adafruit/Adafruit-PWM-Servo-FeatherWing-PCB/PWMServo Featherwing rev B.brd

## EAGLE design PWMServo Featherwing rev B.brd (2016-03-01)

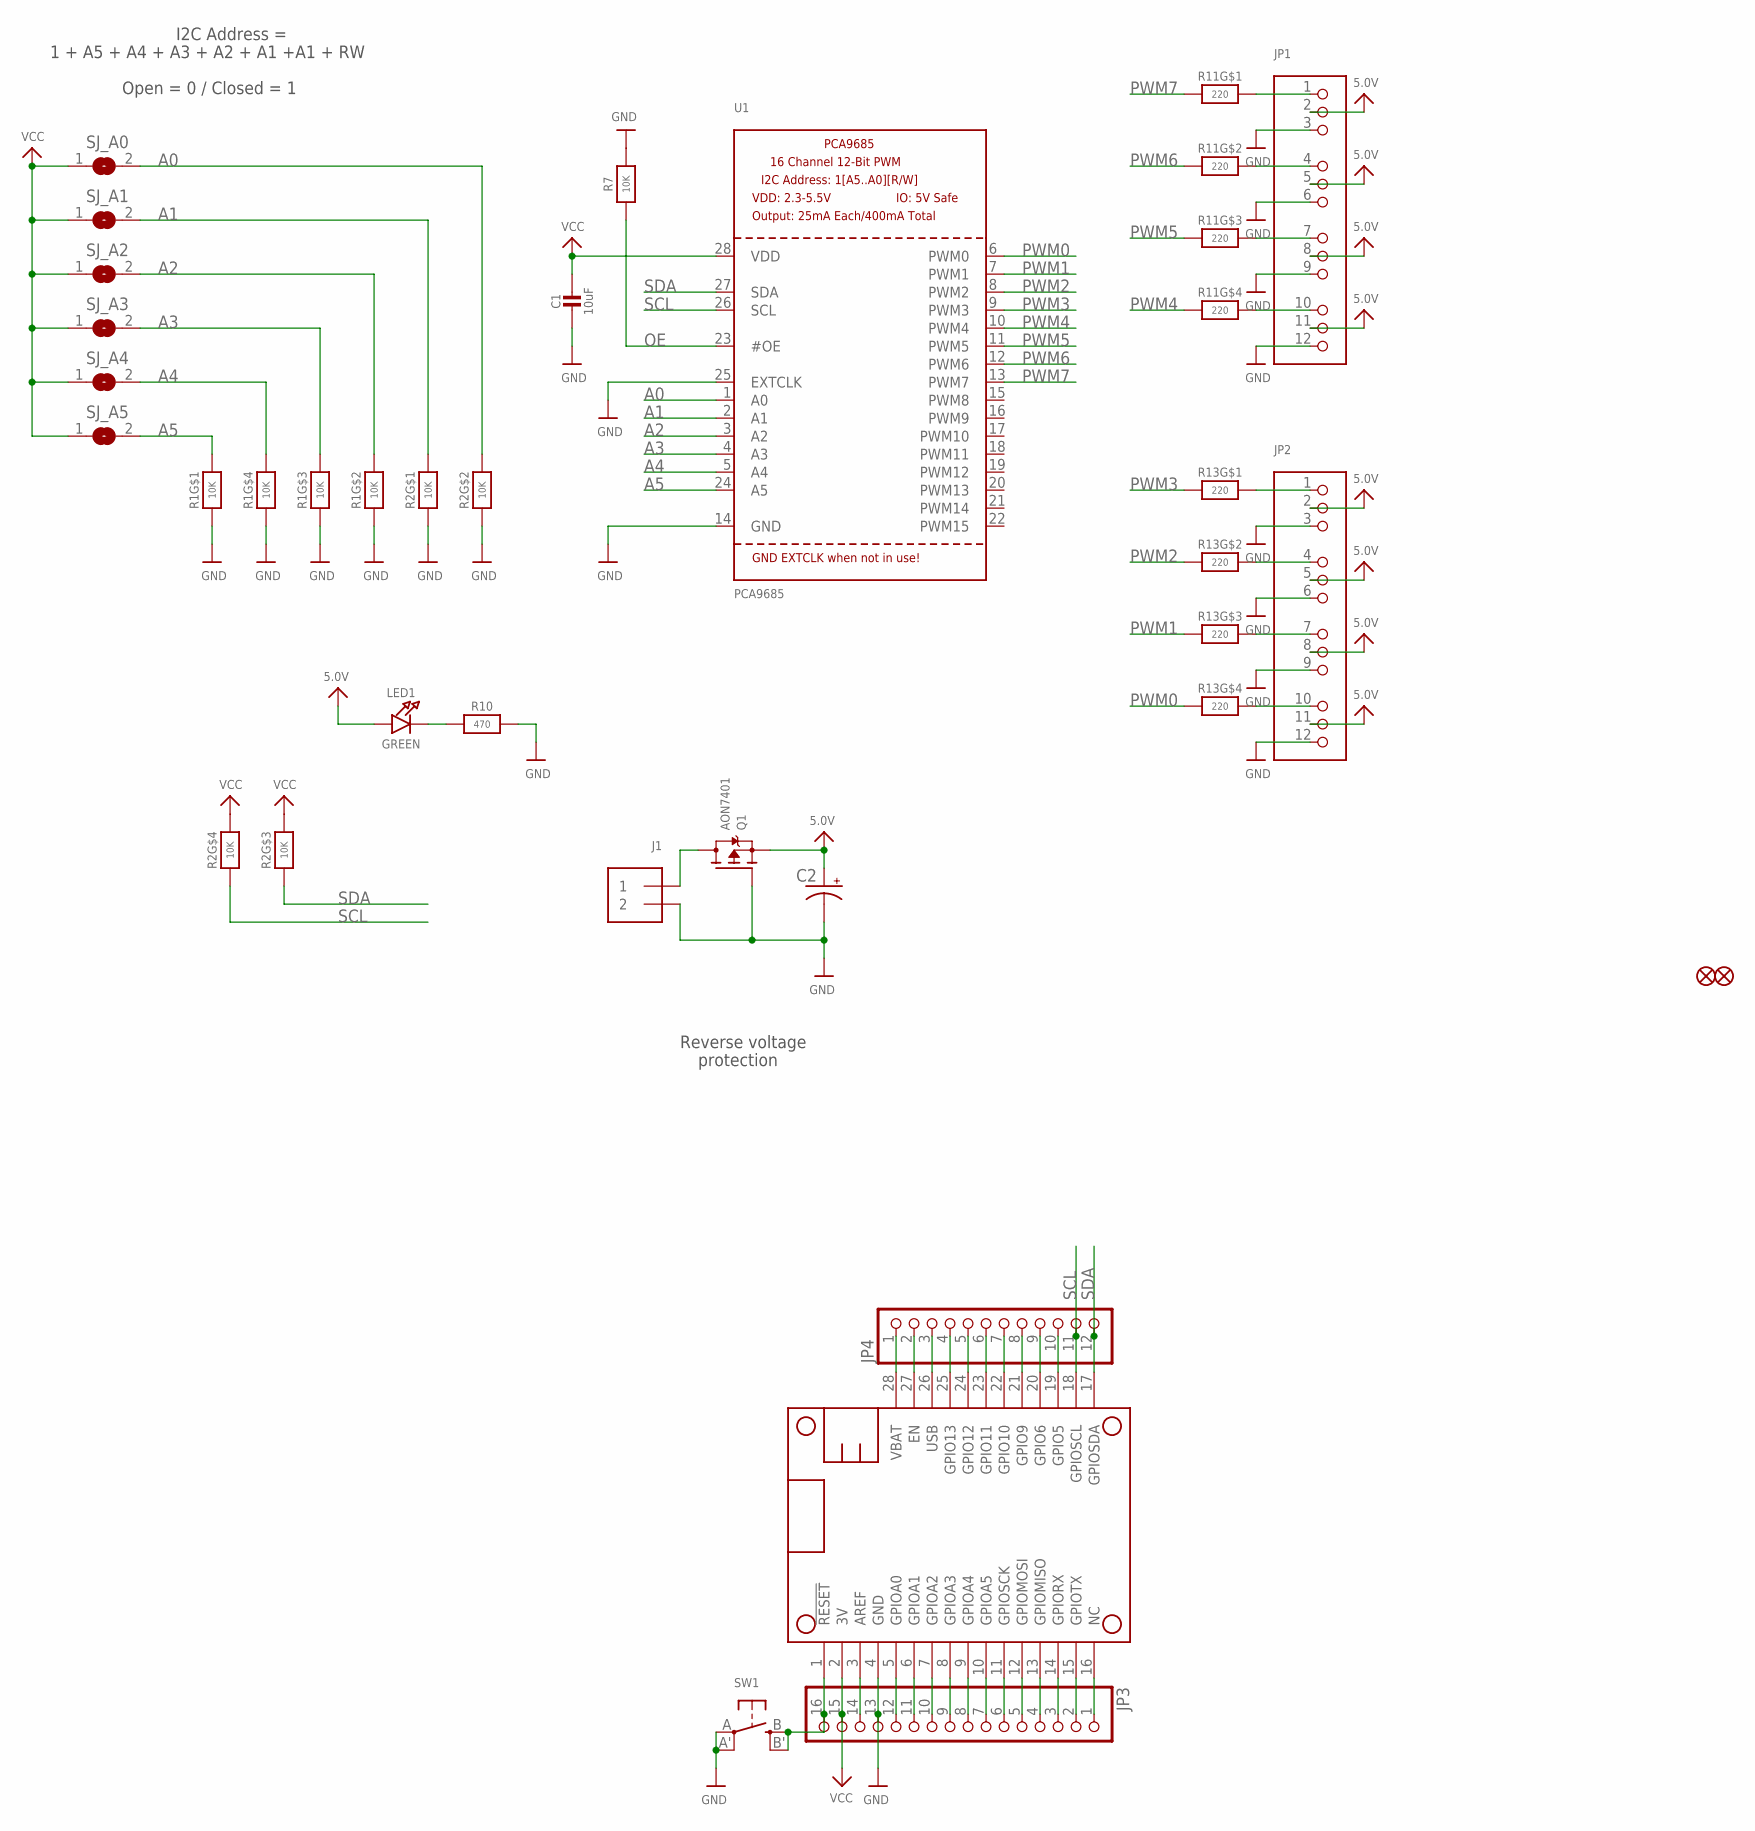
[picture p2: schematic PWMServo Featherwing rev B.sch]

Parts:
C1: 10uF; 0805-NO
C2: CPOL-USE3.5-8; E3,5-8
FID1, FID2: FIDUCIAL""; FIDUCIAL_1MM
J1: TERMBLOCK_1X2; TERMBLOCK_1X2-3.5MM
JP1, JP2: HEADER-3X04; 3X04
JP3: HEADER-1X16ROUND; 1X16_ROUND
JP4: HEADER-1X12; 1X12_ROUND
LED1: GREEN; CHIPLED_0805_NOOUTLINE
MS1: FEATHERWING
Q1: AON7401; POWERDI3333
R1, R2: 10K; RESPACK_4X0603
R7: 10K; 0805-NO
R10: 470; 0805-NO
R11, R13: 220; RESPACK_4X0603
SJ_A0, SJ_A1, SJ_A2, SJ_A3, SJ_A4, SJ_A5: SOLDERJUMPERREFLOW_NOPASTE; SOLDERJUMPER_REFLOW_NOPASTE
SW1: SWITCH_TACT_SMT4.6X2.8; BTN_KMR2_4.6X2.8
U1: PCA9685; TSSOP28

Connections:
5.0V: C2.+, JP1.2, JP1.5, JP1.8, JP1.11, JP2.2, JP2.5, JP2.8, JP2.11, LED1.A, Q1.1 (S), Q1.2 (S), Q1.3 (S)
A0: R2.7 (2), SJ_A0.2, U1.1 (A0)
A1: R2.8 (2), SJ_A1.2, U1.2 (A1)
A2: R1.7 (2), SJ_A2.2, U1.3 (A2)
A3: R1.6 (2), SJ_A3.2, U1.4 (A3)
A4: R1.5 (2), SJ_A4.2, U1.5 (A4)
A5: R1.8 (2), SJ_A5.2, U1.24 (A5)
GND: C1.2, C2.-, J1.2, JP1.3, JP1.6, JP1.9, JP1.12, JP2.3, JP2.6, JP2.9, JP2.12, JP3.13, MS1.4 (GND), Q1.4 (G), R1.1, R1.2 (1), R1.3 (1), R1.4 (1), R2.1, R2.2 (1), R7.2, R10.2, SW1.A, SW1.A' (P1), U1.14 (GND), U1.25 (EXTCLK)
unnamed: LED1.C, R10.1
unnamed: JP1.4, R11.7 (2)
unnamed: JP1.1, R11.8 (2)
unnamed: JP1.7, R11.6 (2)
unnamed: JP1.10, R11.5 (2)
unnamed: JP2.1, R13.8 (2)
unnamed: JP2.4, R13.7 (2)
unnamed: JP2.7, R13.6 (2)
unnamed: JP2.10, R13.5 (2)
unnamed: JP3.1, MS1.16 (NC)
unnamed: JP3.2, MS1.15 (GPIOTX)
unnamed: JP3.3, MS1.14 (GPIORX)
unnamed: JP3.4, MS1.13 (GPIOMISO)
unnamed: JP3.5, MS1.12 (GPIOMOSI)
unnamed: JP3.6, MS1.11 (GPIOSCK)
unnamed: JP3.7, MS1.10 (GPIOA5)
unnamed: JP3.8, MS1.9 (GPIOA4)
unnamed: JP3.9, MS1.8 (GPIOA3)
unnamed: JP3.10, MS1.7 (GPIOA2)
unnamed: JP3.11, MS1.6 (GPIOA1)
unnamed: JP3.12, MS1.5 (GPIOA0)
unnamed: JP3.14, MS1.3 (AREF)
unnamed: JP4.2, MS1.27 (EN)
unnamed: JP4.4, MS1.25 (GPIO13)
unnamed: JP4.5, MS1.24 (GPIO12)
unnamed: JP4.6, MS1.23 (GPIO11)
unnamed: JP4.7, MS1.22 (GPIO10)
unnamed: JP4.8, MS1.21 (GPIO9)
unnamed: JP4.9, MS1.20 (GPIO6)
unnamed: JP4.10, MS1.19 (GPIO5)
unnamed: JP3.16, MS1.1 (!RESET), SW1.B (S), SW1.B' (S1)
OE: R7.1, U1.23 (#OE)
PWM0: R13.4 (1), U1.6 (PWM0)
PWM1: R13.3 (1), U1.7 (PWM1)
PWM2: R13.2 (1), U1.8 (PWM2)
PWM3: R13.1, U1.9 (PWM3)
PWM4: R11.4 (1), U1.10 (PWM4)
PWM5: R11.3 (1), U1.11 (PWM5)
PWM6: R11.2 (1), U1.12 (PWM6)
PWM7: R11.1, U1.13 (PWM7)
PWRIN: J1.1, Q1.5678 (D)
SCL: JP4.11, MS1.18 (GPIOSCL), R2.4 (1), U1.26 (SCL)
SDA: JP4.12, MS1.17 (GPIOSDA), R2.3 (1), U1.27 (SDA)
USB: JP4.3, MS1.26 (USB)
VBAT: JP4.1, MS1.28 (VBAT)
VCC: C1.1, JP3.15, MS1.2 (3V), R2.5 (2), R2.6 (2), SJ_A0.1, SJ_A1.1, SJ_A2.1, SJ_A3.1, SJ_A4.1, SJ_A5.1, U1.28 (VDD)

Notes on the sheet:
Reverse voltage
protection
1 + A5 + A4 + A3 + A2 + A1 +A1 + RW
I2C Address =
Open = 0 / Closed = 1

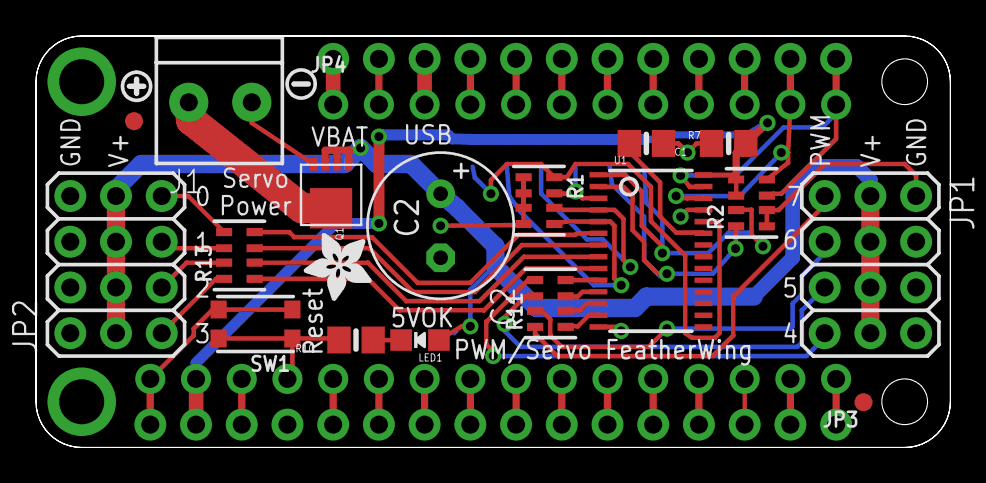
[picture p3: board PWMServo Featherwing rev B.brd from above]

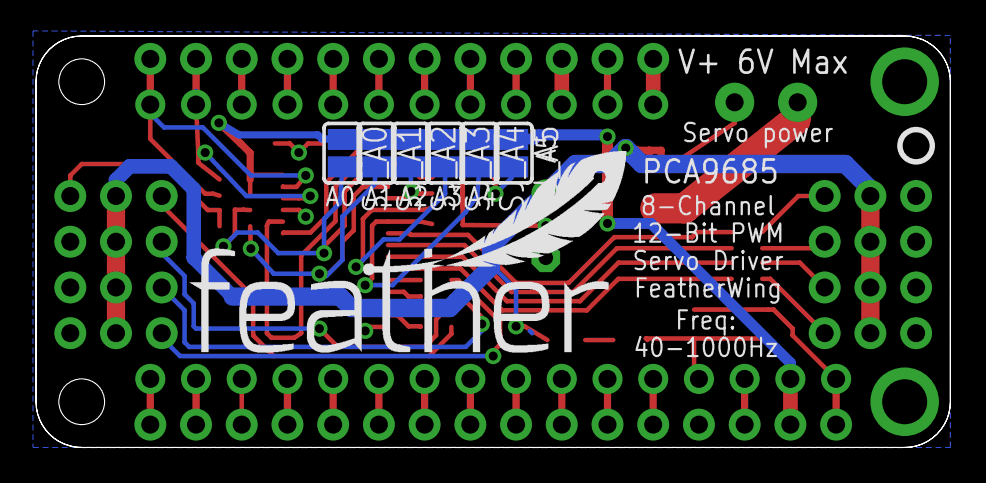
[picture p4: board PWMServo Featherwing rev B.brd from below]

Board: 2 copper layers, 50.8 x 22.9 mm, 31 parts (8 on the bottom side), 54 nets.

Other parts of the board:
U$11: SYMBOL_PLUS
U$12: SYMBOL_MINUS
U$14: ADAFRUIT_3.5MM
U$15: FEATHERLOGO
U$16: PCBFEAT-REV-040
